gabebuckmaster/Si4825-AM-FM-Radio-Kit-TH/README.md

# Si4825-AM-FM-Radio-Kit-TH
Si4825 AM/FM Radio Kit (Through Hole)
