gabebuckmaster/Si4825-AM-FM-Radio-Kit-TH/Si4825_KIT_TH_pcb_preview_bottom.png

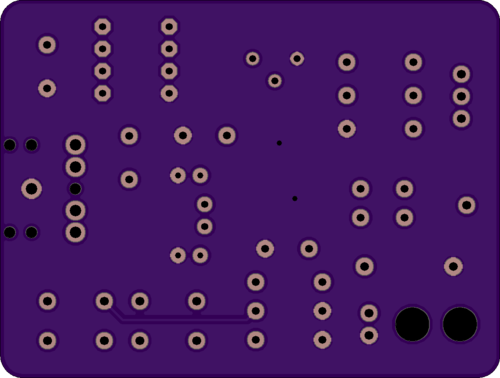
Si4825_KIT_TH_pcb_preview_bottom.png
