gabebuckmaster/Si4825-AM-FM-Radio-Kit-TH/Si4825_KIT_TH_pcb_preview_top.png

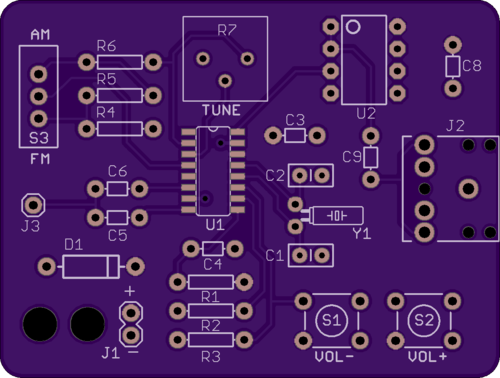
Si4825_KIT_TH_pcb_preview_top.png
