gabebuckmaster/Si4825-AM-FM-Radio-Kit-TH/SI4825_KIT_TH_BOM.xlsx

Ref Des | Description | Manufacturer | MPN | Qty | Price at Qty*20 | Link | Alternate
C1, C2 | 22pF 2.5mm radial Capacitor C0G | Vishay | K220J15C0GF5TL2 | 2 | 0.139 | http://www.digikey.com/product-detail/en/vishay-bc-components/K220J15C0GF5TL2/BC1005CT-ND/286627
C3-C6, C8 | 1uF 5mm radial Capacitor X7R | Murata | RDER71H105K2M1H03A | 5 | 0.2401 | http://www.digikey.com/product-detail/en/murata-electronics-north-america/RDER71H105K2M1H03A/490-9146-1-ND/4772308
C9 | 22uF 5mm radial Capacitor X5R | TDK | FK24X5R0J226M | 1 | 0.319 | http://www.digikey.com/product-detail/en/tdk-corporation/FK24X5R0J226M/445-8492-ND/2815422
D1 | 1A General Purpose Diode | Any | 1N4001 | 1 | 0.099 | http://www.digikey.com/product-detail/en/micro-commercial-co/1N4001-TP/1N4001-TPMSCT-ND/773688
J1 | Connection point for battery pack |  |  | 0
J2 | Headphone Jack | CUI Inc | SJ1-3523NG | 1 | 0.808 | http://www.digikey.com/product-search/en?keywords=SJ1-3523NG
J3 | Antenna connection point |  |  | 0
R1-R3 | 100kOhm 5% 1/4W Resistor | Any |  | 3 | 0.061 | http://www.digikey.com/product-detail/en/yageo/CFR-25JB-52-100K/100KQBK-ND/245
R4 | 76.8kOhm 1% 1/4W Resistor | Any |  | 1 | 0.084 | http://www.digikey.com/product-detail/en/yageo/MFR-25FBF52-76K8/76.8KXBK-ND/13451
R5 | 150kOhm 1% 1/4W Resistor | Any |  | 1 | 0.084 | http://www.digikey.com/product-detail/en/yageo/MFR-25FBF52-150K/150KXBK-ND/13508
R6 | 274kOhm 1% 1/4W Resistor | Any |  | 1 | 0.084 | http://www.digikey.com/product-detail/en/yageo/MFR-25FBF52-274K/274KXBK-ND/13575
R7 | 100kOhm Potentiometer | Bourns | 3386P-1-104TLF | 1 | 2.175 | http://www.digikey.com/product-search/en?keywords=3386P-1-104TLF
R8 | Jumper |  |  | NOSTUFF
S1, S2 | Momentary Pushbutton Switch - NO | TE Connectivity | 1825910-6 | 2 | 0.088 | http://www.digikey.com/product-detail/en/te-connectivity-alcoswitch-switches/1825910-6/450-1650-ND/1632536
S3 | SPDT switch | E-Switch | EG1218 | 1 | 0.559 | http://www.digikey.com/product-detail/en/e-switch/EG1218/EG1903-ND/101726
U1 | Multi-band Radio Receiver IC | SiLabs | SI4825-A10-CS | 1
U2 | Dual low-voltage op amp (PDIP-8) | Microchip | MCP6002-E/P | 1 | 0.3 | http://www.digikey.com/product-detail/en/microchip-technology/MCP6002-E-P/MCP6002-E-P-ND/683196
Y1 | 32.768 kHz Crystal (cylindrical can, radial) | Citizen Finedevice Co Ltd | CFS-20632768DZBB | 1 | 0.2 | http://www.digikey.com/product-detail/en/citizen-finedevice-co-ltd/CFS-20632768DZBB/300-8301-ND/862578
XX | Battery holder with switch | Memory Protection Devices | SBH321AS | 1 | 2.14 | http://www.digikey.com/product-detail/en/mpd-memory-protection-devices/SBH321AS/SBH321AS-ND/275301 | http://www.digikey.com/product-search/en?keywords=SBH421AS-ND
XX | Si4825 Through Hole Kit PCB
