gabebuckmaster/Si4825-AM-FM-Radio-Kit-TH/Si4825_KIT_TH_schematic.pdf

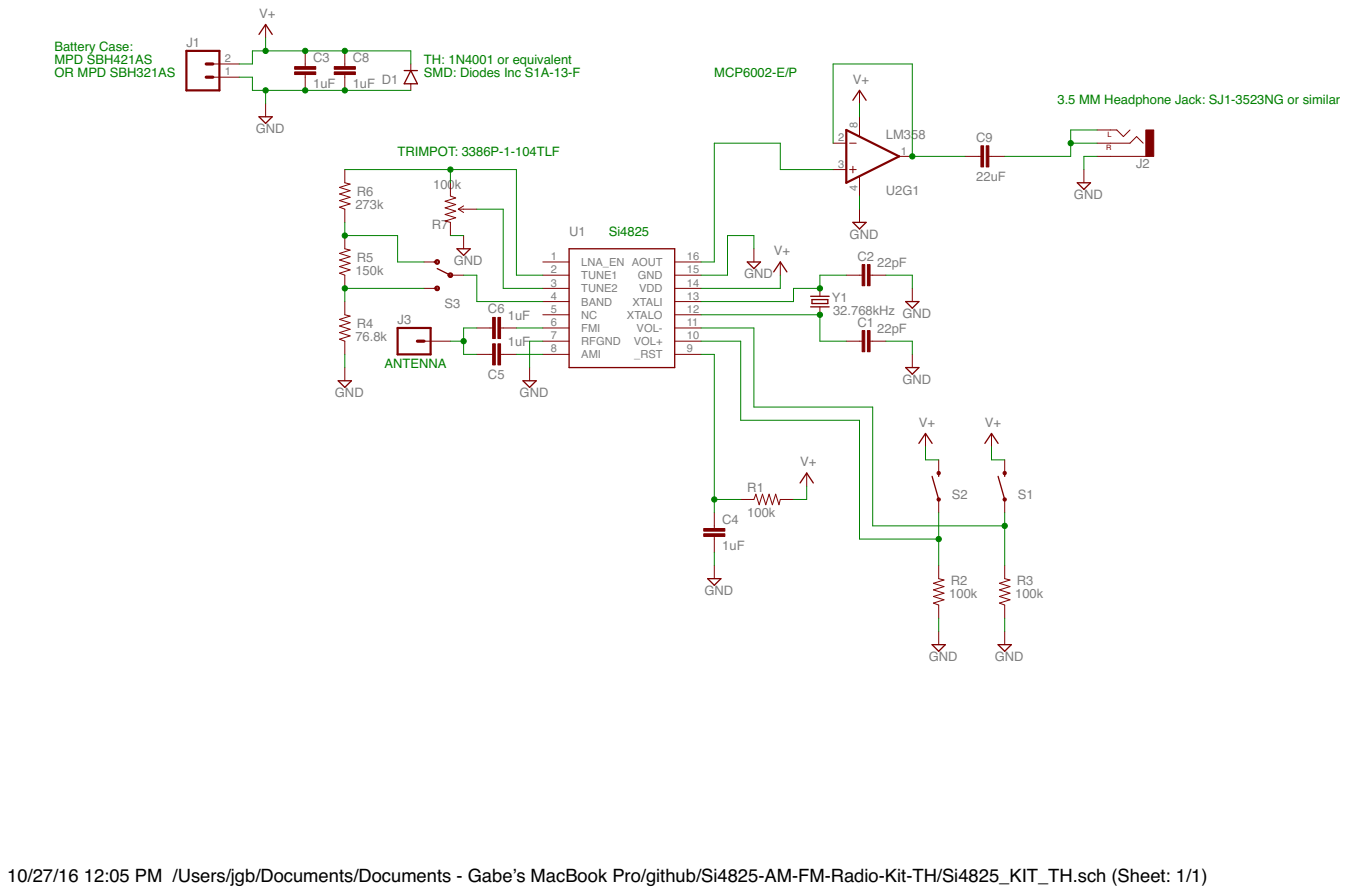
[picture p3: page 1]

10/27/16 12:05 PM /Users/jgb/Documents/Documents - Gabe’s MacBook Pro/github/Si4825-AM-FM-Radio-Kit-TH/Si4825_KIT_TH.sch (Sheet: 1/1)
