gabebuckmaster/Si4825-AM-FM-Radio-Kit-TH/Si4825_KIT_TH.brd

## EAGLE design Si4825_KIT_TH.brd (2016-10-27)

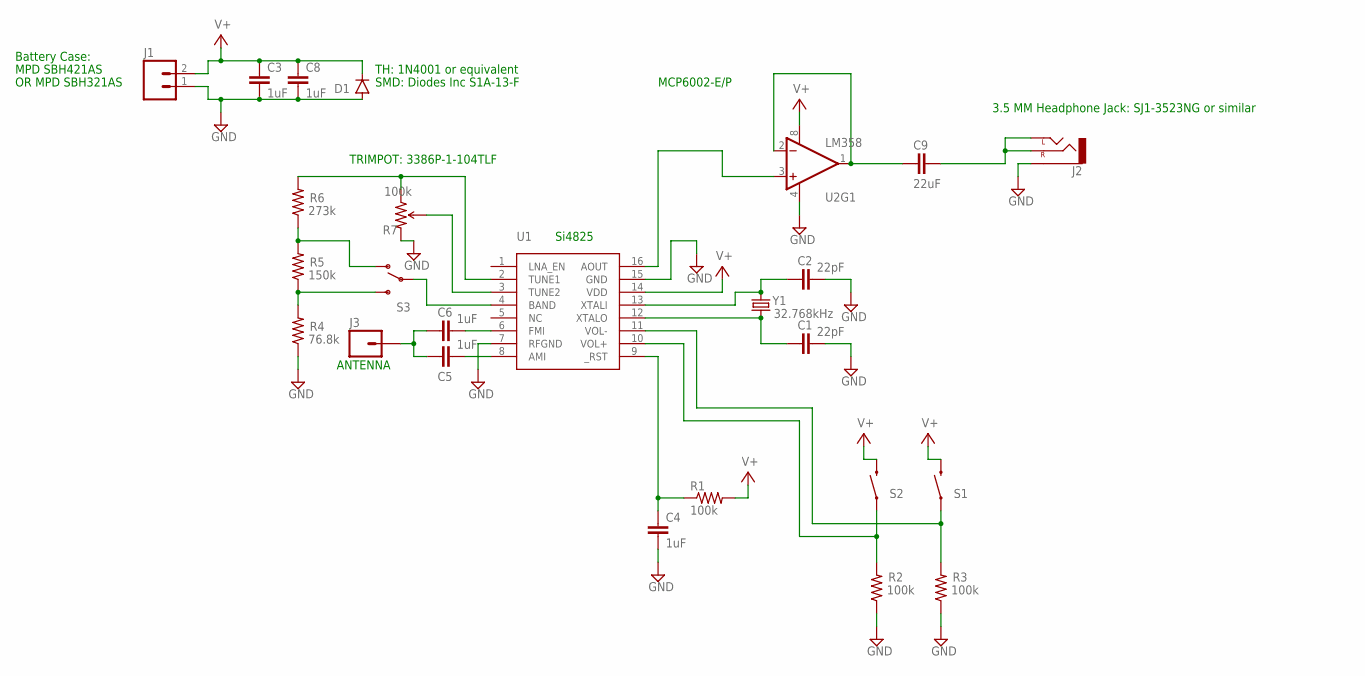
[picture p4: schematic Si4825_KIT_TH.sch]

Parts:
C1, C2: 22pF; CAP-PTH-SMALL2
C3, C4, C5, C6, C8: 1uF; AXIAL-5MM
C9: 22uF; AXIAL-5MM
D1: DIODEPTH; DIODE-1N4001
J1: M02PTH; 1X02
J2: AUDIO-JACKPTH; AUDIO-JACK
J3: M01PTH; 1X01
R1, R2, R3: 100k; AXIAL-0.3
R4: 76.8k; AXIAL-0.3
R5: 150k; AXIAL-0.3
R6: 273k; AXIAL-0.3
R7: 100k; BOURNS_3386P
S1, S2: SWITCH-MOMENTARY-2PTH; TACTILE-PTH
S3: SWITCH-SPDTPTH; SWITCH-SPDT
U1: SI4825; SO16
U2: LM358; DIP08
Y1: 32.768kHz; TC26H

Connections:
GND: C1.2, C2.2, C3.P$2 (2), C4.P$2 (2), C8.P$2 (2), D1.A, J1.1, J2.SLEEVE, R2.P$1 (1), R3.P$1 (1), R4.P$1 (1), R7.P$3 (CW), U1.7 (RFGND), U1.15 (GND), U2.4 (V-)
unnamed: C5.P$2 (2), U1.8 (AMI)
unnamed: C1.1, U1.12 (XTALO), Y1.2
unnamed: C2.1, U1.13 (XTALI), Y1.1
unnamed: C4.P$1 (1), R1.P$1 (1), U1.9 (_RST)
unnamed: R2.P$2 (2), S2.1, U1.10 (VOL+)
unnamed: R3.P$2 (2), S1.1, U1.11 (VOL-)
unnamed: S3.2, U1.4 (BAND)
unnamed: R4.P$2 (2), R5.P$1 (1), S3.3 (S)
unnamed: R5.P$2 (2), R6.P$1 (1), S3.1 (O)
unnamed: R6.P$2 (2), R7.P$1 (CCW), U1.2 (TUNE1)
unnamed: C6.P$2 (2), U1.6 (FMI)
unnamed: R7.P$2 (WIPER), U1.3 (TUNE2)
unnamed: C9.P$1 (1), U2.1 (OUT), U2.2 (-IN)
unnamed: U1.16 (AOUT), U2.3 (+IN)
unnamed: C5.P$1 (1), C6.P$1 (1), J3.1
unnamed: C9.P$2 (2), J2.RING (RIGHT), J2.TIP (LEFT)
V+: C3.P$1 (1), C8.P$1 (1), D1.C, J1.2, R1.P$2 (2), S1.3 (2), S2.3 (2), U1.14 (VDD), U2.8 (V+)

Notes on the sheet:
TRIMPOT: 3386P-1-104TLF
MPD SBH421AS
OR MPD SBH321AS
TH: 1N4001 or equivalent
Battery Case:
3.5 MM Headphone Jack: SJ1-3523NG or similar
SMD: Diodes Inc S1A-13-F
ANTENNA
Si4825
MCP6002-E/P

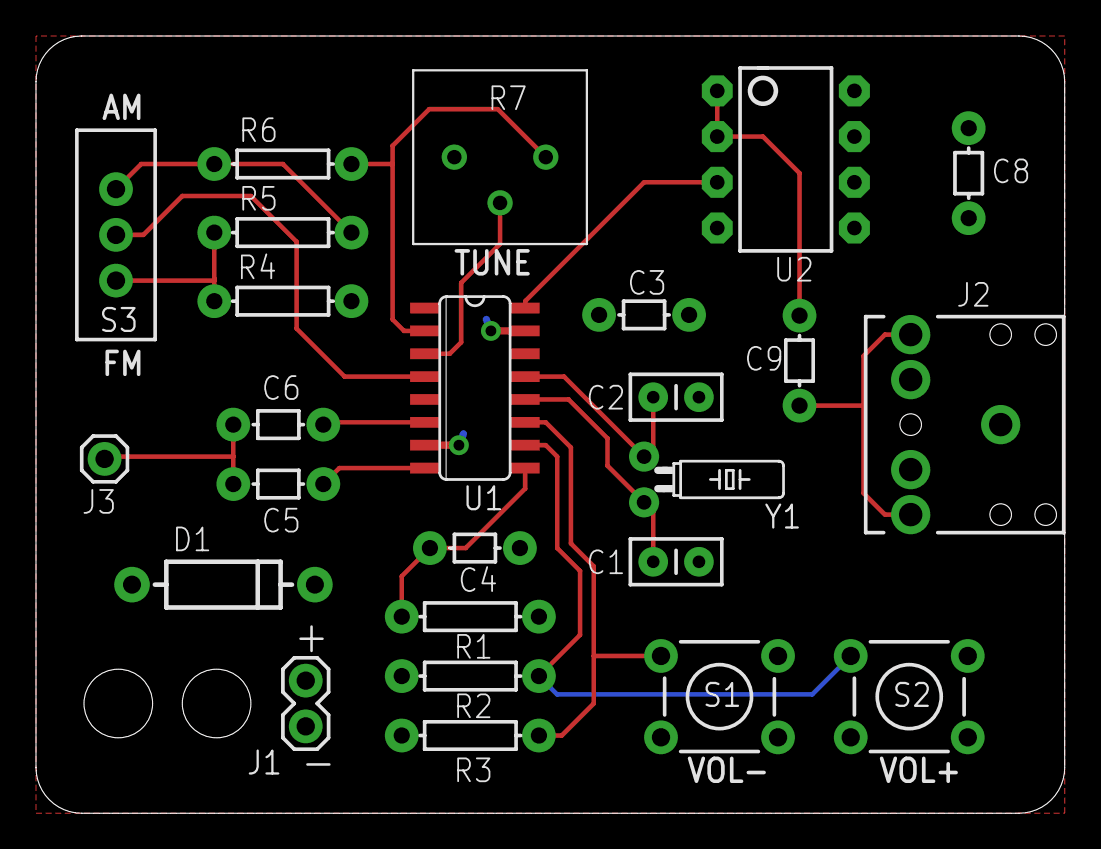
[picture p5: board Si4825_KIT_TH.brd from above]

Board: 2 copper layers, 57.1 x 43.2 mm, 25 parts (0 on the bottom side), 18 nets.
