gabebuckmaster/Si4825-AM-FM-Radio-Kit-TH/(commit log)

2016-09-21 Added initial design
    [SI4825_KIT_TH_BOM.xlsx, Si4825_KIT_TH.brd, Si4825_KIT_TH.sch]
2016-10-27 Fixed issues discovered in first build
    - fixed potentiometer footprint
    - bigger strain relief holes: .1” to .15”
    - changed U2 (op amp) to through hole version
    - changed value of C9 (AC coupling capacitor) to 22uF in BOM and
    schematic
    - Removed R8 (jumper to bypass op amp)
    - Regenerated gerbers, jpg previews, and pdf of schematic
    [SI4825_KIT_TH_BOM.xlsx, Si4825_KIT_TH.brd, Si4825_KIT_TH.sch]
2017-04-03 Fixed Typo in BOM
    Line 21 Trough -> Through
    [SI4825_KIT_TH_BOM.xlsx]
